pcailliatte/OpenMowerECU/Doc/assets/img/MowerBoard_preview.png

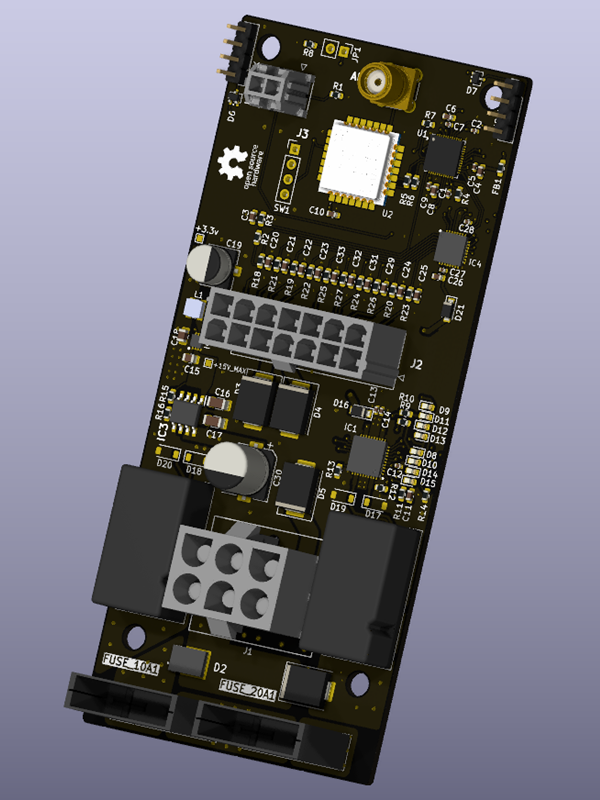
Doc/assets/img/MowerBoard_preview.png
