pcailliatte/OpenMowerECU/Hardware/STAUB_BLIZZARD_107L/MowerBoard.kicad_pcb

## KiCad design Hardware/STAUB_BLIZZARD_107L/MowerBoard.kicad_pcb (2026-08-01)

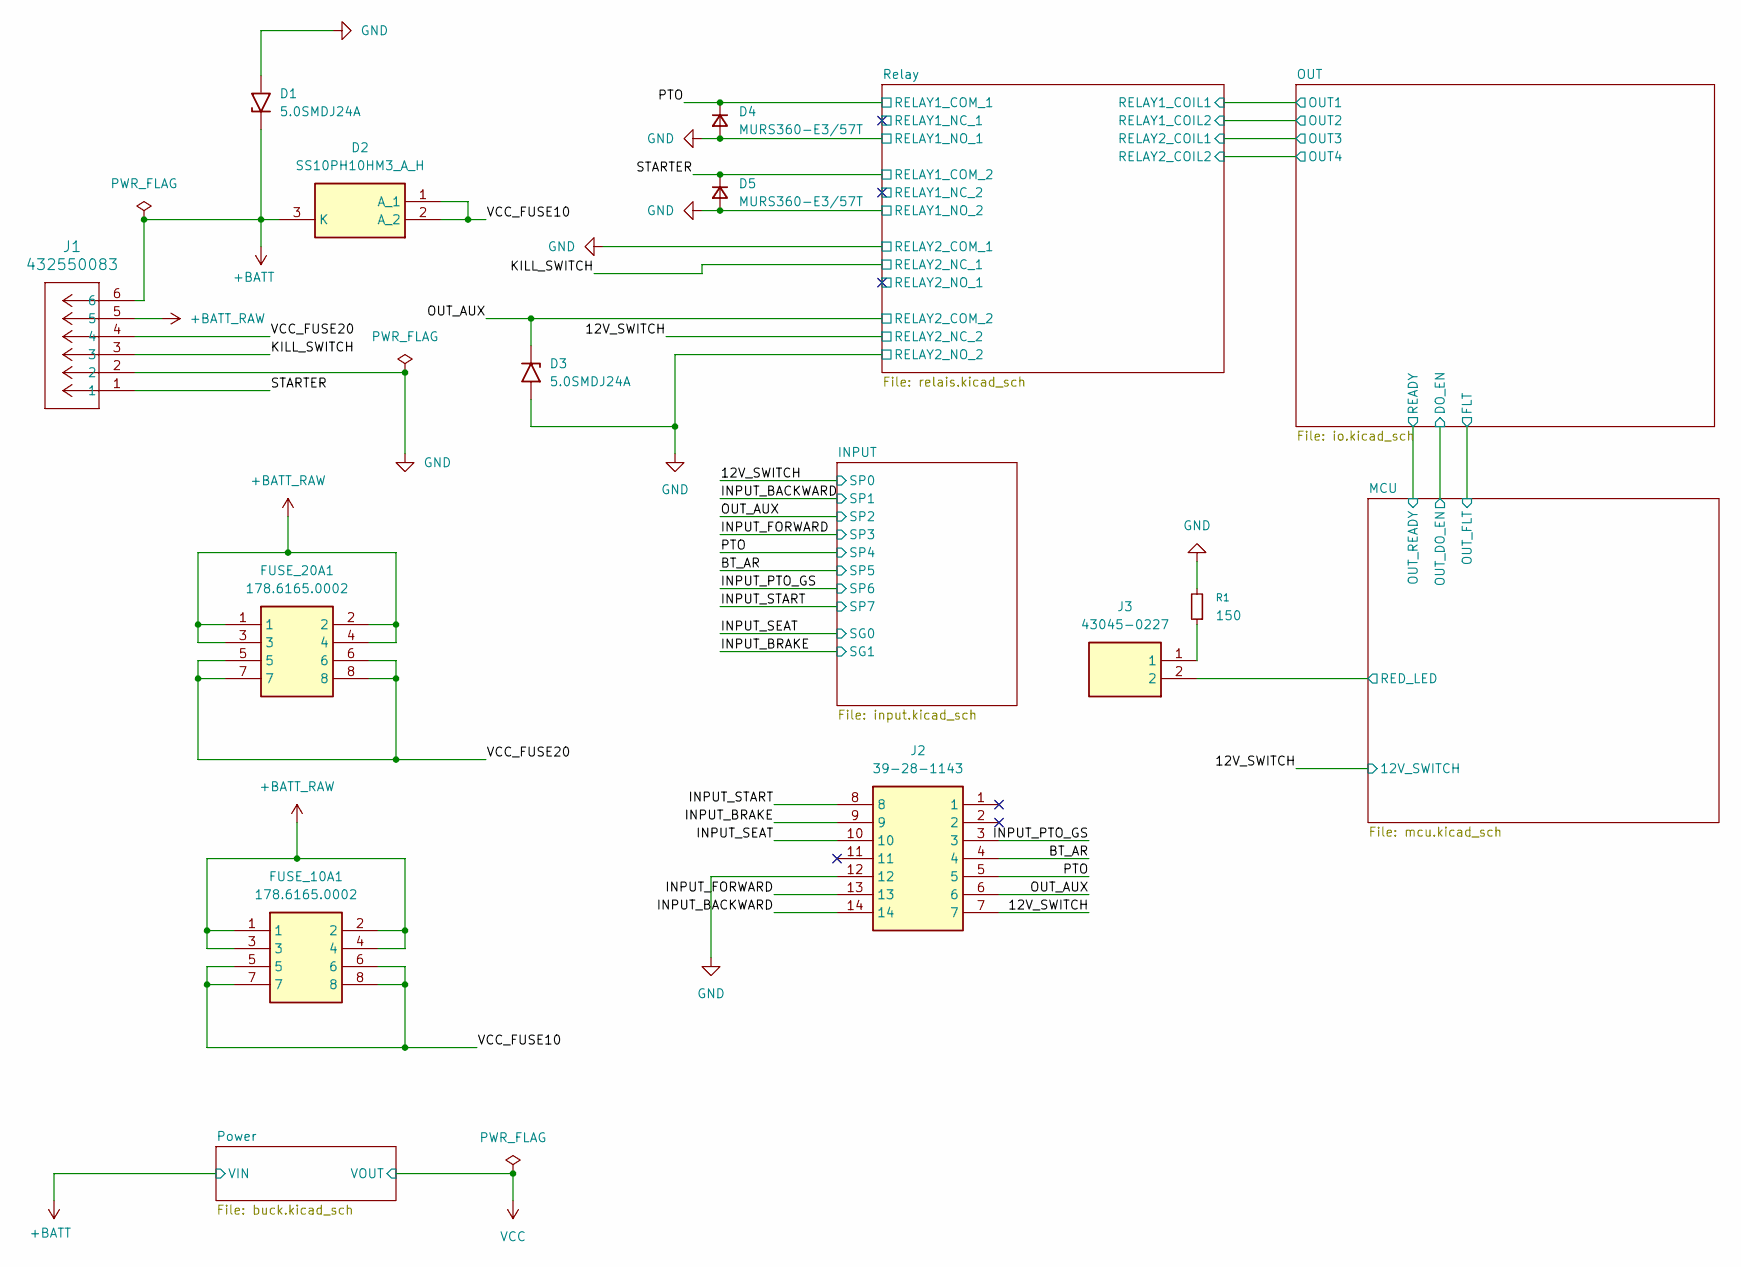
[picture p2: schematic MowerBoard.kicad_sch]

Parts:
D1, D3: 5.0SMDJ24A; D_SMC; Mouser Part Number 576-5.0SMDJ24A
D2: SS10PH10HM3_A_H; V10PN50M387A; Mouser Part Number 78-SS10PH10HM3_A/H
D4, D5: MURS360-E3/57T; D_SMC
FUSE_10A1, FUSE_20A1: 178.6165.0002; 17861650002; Mouser Part Number 576-178.6165.0002
J1: 432550083; CONN_SDA_43255-00xx_06_MOL_NO_MARK
J2: 39-28-1143; Mouser Part Number 538-39-28-1143
J3: 43045-0227; 43045-02YY_272829; Mouser Part Number 538-43045-0227
R1: 150; R_0603_1608Metric

Connections:
+BATT: D1.1 (A1), D2.3 (K), J1.6; also elsewhere on the board
+BATT_RAW: FUSE_10A1.1, FUSE_10A1.2, FUSE_10A1.3, FUSE_10A1.4, FUSE_20A1.1, FUSE_20A1.2, FUSE_20A1.3, FUSE_20A1.4, J1.5
/12V_SWITCH: J2.7; also elsewhere on the board
/BT_AR: J2.4; also elsewhere on the board
/INPUT_BACKWARD: J2.14; also elsewhere on the board
/INPUT_BRAKE: J2.9; also elsewhere on the board
/INPUT_FORWARD: J2.13; also elsewhere on the board
/INPUT_PTO_GS: J2.3; also elsewhere on the board
/INPUT_SEAT: J2.10; also elsewhere on the board
/INPUT_START: J2.8; also elsewhere on the board
/KILL_SWITCH: J1.3; also elsewhere on the board
/MCU/RED_LED: J3.2; also elsewhere on the board
/OUT_AUX: D3.1 (A1), J2.6; also elsewhere on the board
/PTO: D4.1 (K), J2.5; also elsewhere on the board
/STARTER: D5.1 (K), J1.1; also elsewhere on the board
/VCC_FUSE10: D2.1 (A_1), D2.2 (A_2), FUSE_10A1.5, FUSE_10A1.6, FUSE_10A1.7, FUSE_10A1.8
/VCC_FUSE20: FUSE_20A1.5, FUSE_20A1.6, FUSE_20A1.7, FUSE_20A1.8, J1.4
GND: D1.2 (A2), D3.2 (A2), D4.2 (A), D5.2 (A), J1.2, J2.12, R1.2; also elsewhere on the board
unnamed: J3.1, R1.1

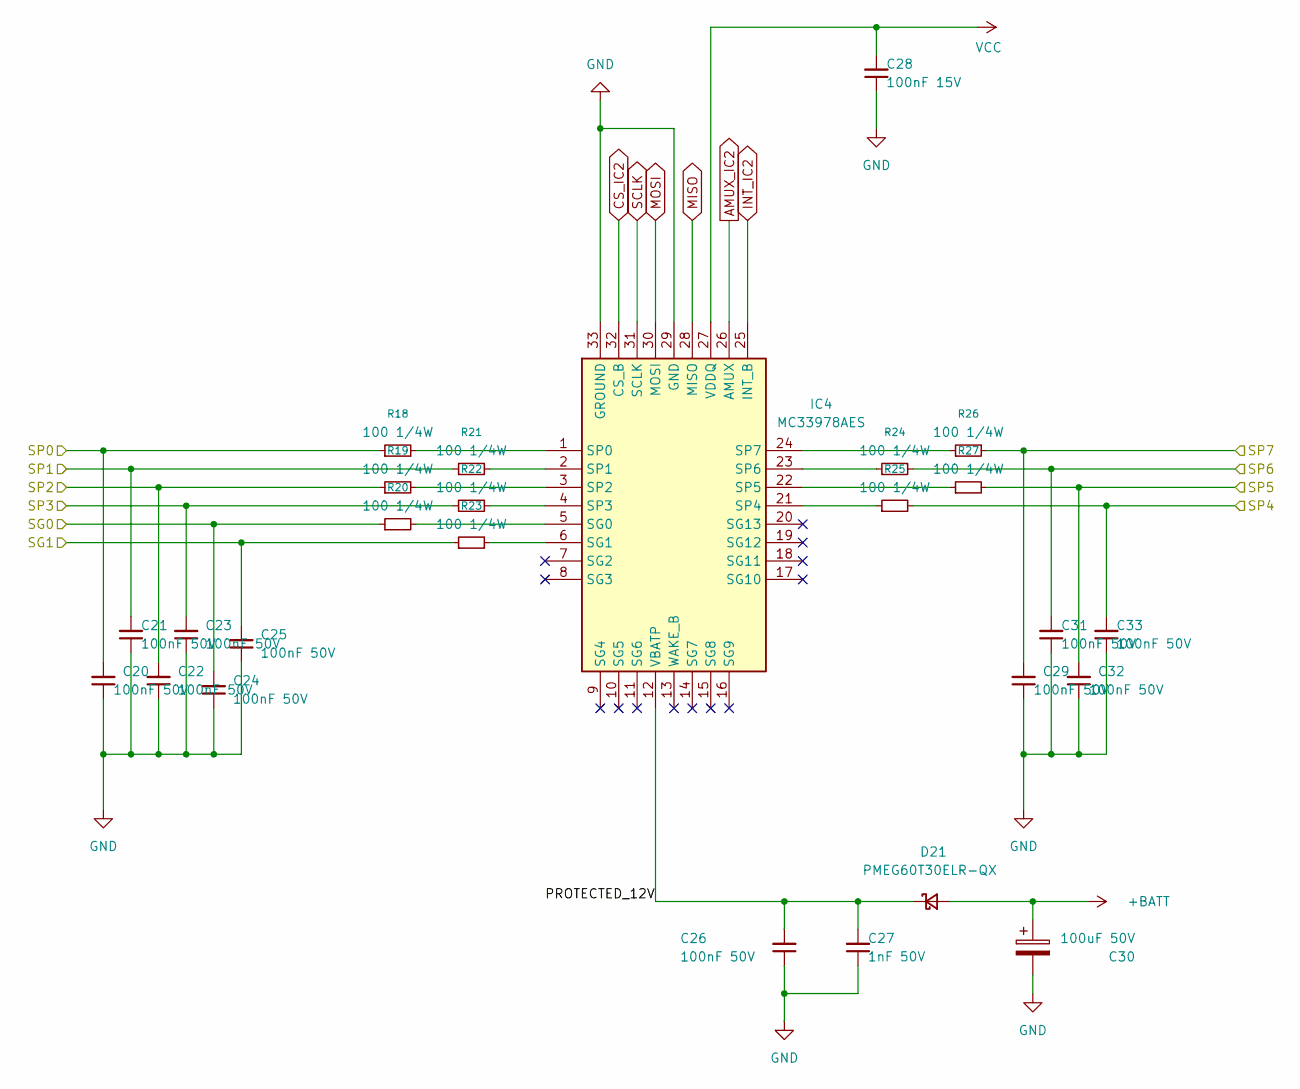
[picture p3: schematic input.kicad_sch]

Parts:
C20, C21, C22, C23, C24, C25, C26, C29, C31, C32, C33: 100nF 50V; C_0603_1608Metric
C27: 1nF 50V; C_0402_1005Metric
C28: 100nF 15V; C_0402_1005Metric
C30: 100uF 50V; CP_Elec_8x10
D21: PMEG60T30ELR-QX; Nexperia_CFP3_SOD-123W
IC4: MC33978AES; QFN50P500X500X90-33N-D_Pasta; Mouser Part Number 841-MC33978AES
R18, R19, R20, R21, R22, R23, R24, R25, R26, R27: 100 1/4W; R_0603_1608Metric

Connections:
+BATT: C30.1, D21.2 (A); also elsewhere on the board
/12V_SWITCH: C20.2, R18.1; also elsewhere on the board
/BT_AR: C32.2, R27.2; also elsewhere on the board
/INPUT/PROTECTED_12V: C26.2, C27.2, D21.1 (K), IC4.12 (VBATP)
/INPUT_BACKWARD: C21.2, R21.1; also elsewhere on the board
/INPUT_BRAKE: C25.2, R23.1; also elsewhere on the board
/INPUT_FORWARD: C23.2, R22.1; also elsewhere on the board
/INPUT_PTO_GS: C31.2, R24.2; also elsewhere on the board
/INPUT_SEAT: C24.2, R20.1; also elsewhere on the board
/INPUT_START: C29.2, R26.2; also elsewhere on the board
/OUT_AUX: C22.2, R19.1; also elsewhere on the board
/PTO: C33.2, R25.2; also elsewhere on the board
AMUX_IC2: IC4.26 (AMUX); also elsewhere on the board
CS_IC2: IC4.32 (CS_B); also elsewhere on the board
GND: C20.1, C21.1, C22.1, C23.1, C24.1, C25.1, C26.1, C27.1, C28.1, C29.1, C30.2, C31.1, C32.1, C33.1, IC4.29 (GND), IC4.33 (GROUND); also elsewhere on the board
INT_IC2: IC4.25 (INT_B); also elsewhere on the board
MISO: IC4.28 (MISO); also elsewhere on the board
MOSI: IC4.30 (MOSI); also elsewhere on the board
unnamed: IC4.5 (SG0), R20.2
unnamed: IC4.6 (SG1), R23.2
unnamed: IC4.1 (SP0), R18.2
unnamed: IC4.2 (SP1), R21.2
unnamed: IC4.3 (SP2), R19.2
unnamed: IC4.4 (SP3), R22.2
unnamed: IC4.21 (SP4), R25.1
unnamed: IC4.22 (SP5), R27.1
unnamed: IC4.23 (SP6), R24.1
unnamed: IC4.24 (SP7), R26.1
SCLK: IC4.31 (SCLK); also elsewhere on the board
VCC: C28.2, IC4.27 (VDDQ); also elsewhere on the board

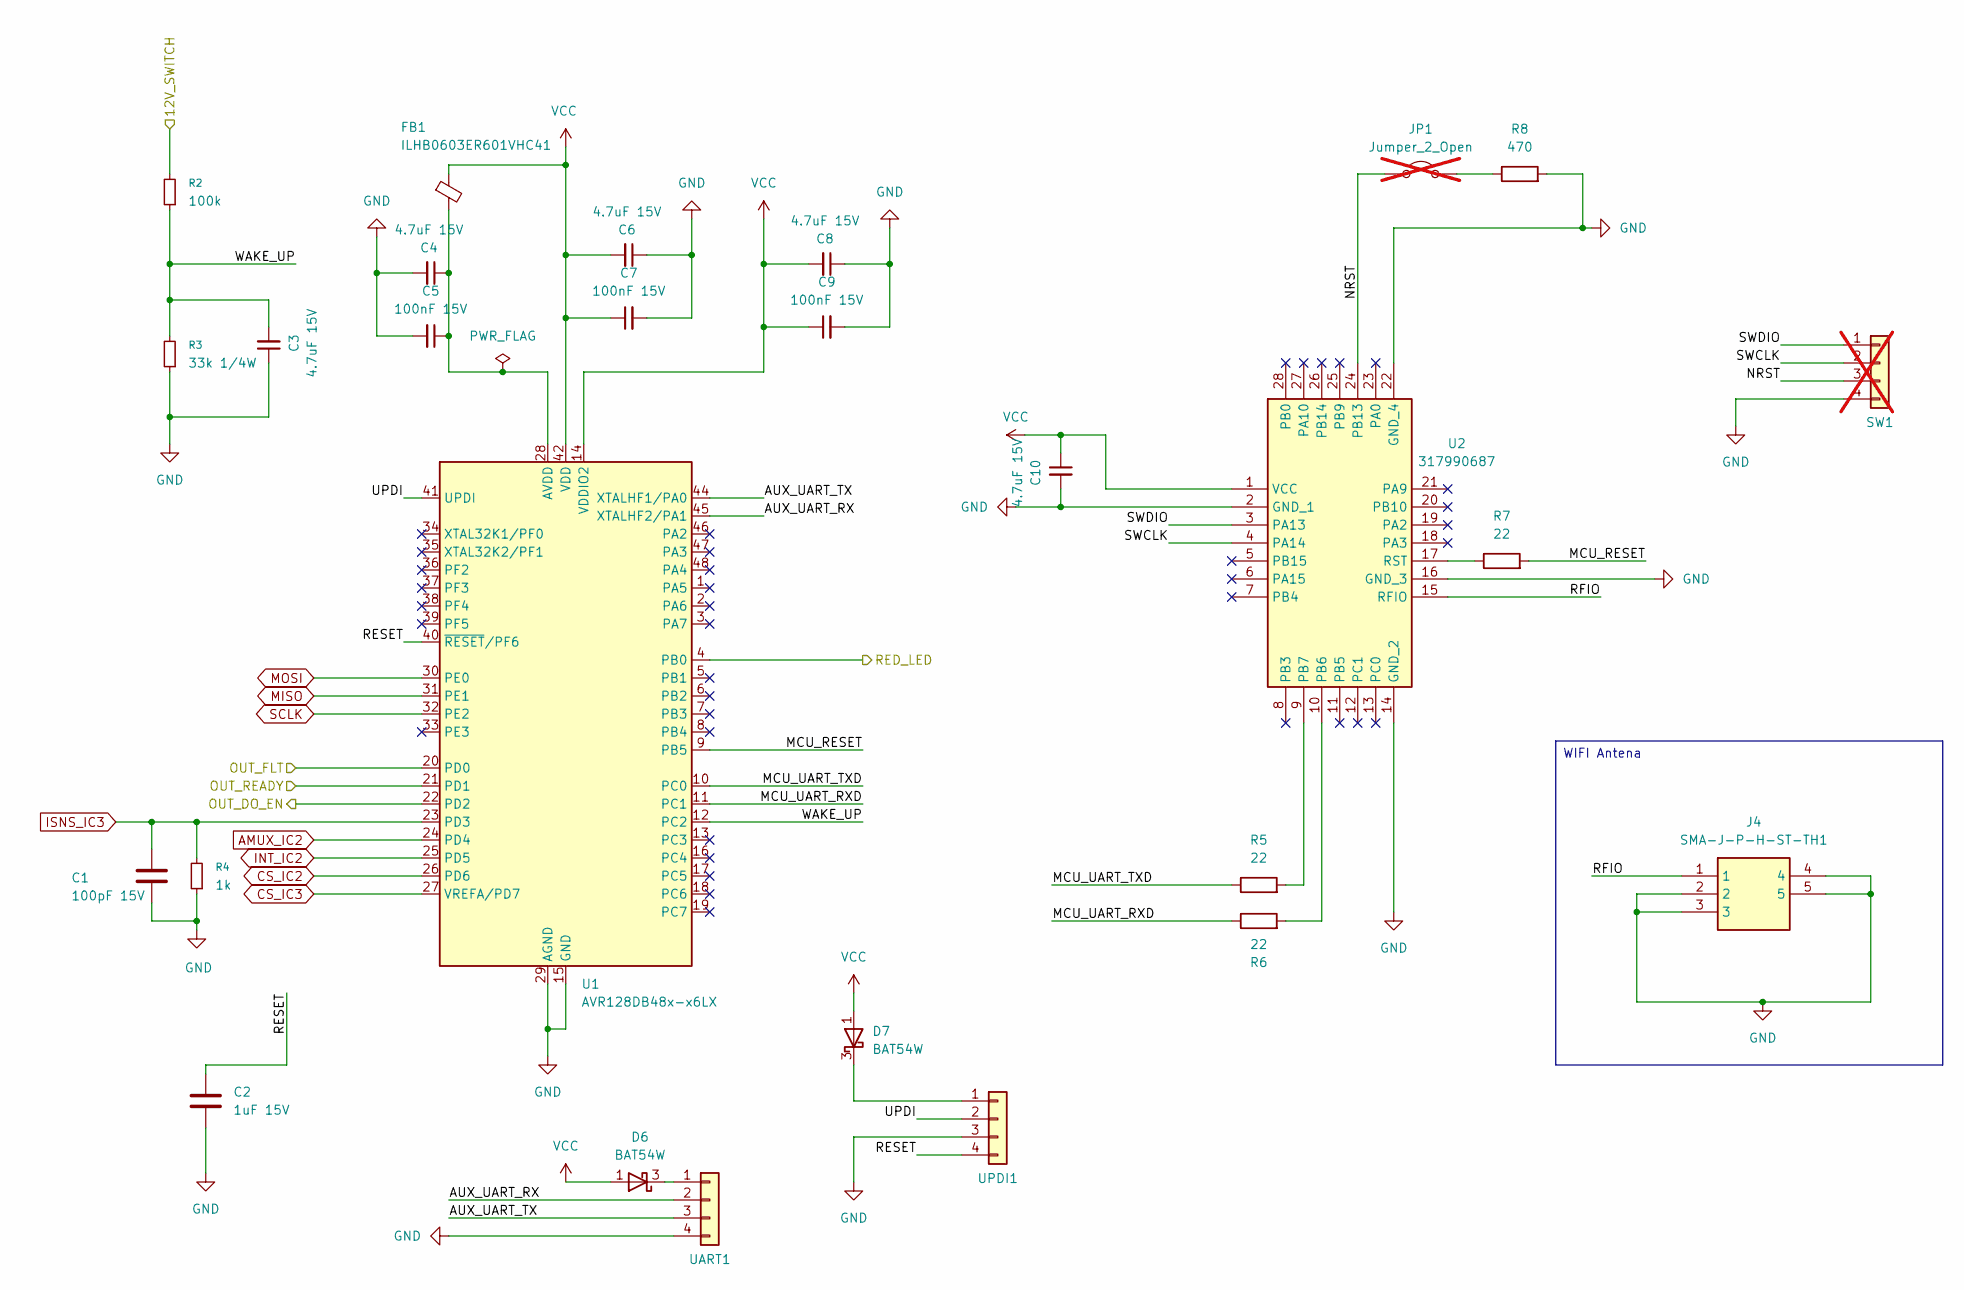
[picture p4: schematic mcu.kicad_sch]

Parts:
C1: 100pF 15V; C_0402_1005Metric
C2: 1uF 15V; C_0402_1005Metric
C3, C4, C6, C8, C10: 4.7uF 15V; C_0603_1608Metric
C5, C7, C9: 100nF 15V; C_0402_1005Metric
D6, D7: BAT54W; SOT-323_SC-70
FB1: ILHB0603ER601VHC41; R_0603_1608Metric_Pad0.98x0.95mm_HandSolder
J4: SMA-J-P-H-ST-TH1; SMAJPHSTTH1; Mouser Part Number 200-SMAJPHSTTH1
JP1: Jumper_2_Open; PinHeader_1x02_P2.54mm_Vertical; not fitted
R2: 100k; R_0603_1608Metric
R3: 33k 1/4W; R_0603_1608Metric
R4: 1k; R_0603_1608Metric
R5, R6, R7: 22; R_0603_1608Metric
R8: 470; R_0603_1608Metric
SW1: PinHeader_1x04_P2.54mm_Vertical; not fitted
U1: AVR128DB48x-x6LX; VQFN-48-1EP_6x6mm_P0.4mm_EP4.1x4.1mm
U2: 317990687; Mouser Part Number 713-317990687
UART1: PinHeader_1x04_P2.54mm_Vertical
UPDI1: PinHeader_1x04_P2.54mm_Vertical

Connections:
/12V_SWITCH: R2.2; also elsewhere on the board
/MCU/AUX_UART_RX: U1.45 (XTALHF2/PA1), UART1.2
/MCU/AUX_UART_TX: U1.44 (XTALHF1/PA0), UART1.3
/MCU/MCU_RESET: R7.2, U1.9 (PB5)
/MCU/MCU_UART_RXD: R6.1, U1.11 (PC1)
/MCU/MCU_UART_TXD: R5.1, U1.10 (PC0)
/MCU/NRST: JP1.1 (A), SW1.3, U2.24 (PB13)
/MCU/OUT_FLT: U1.20 (PD0); also elsewhere on the board
/MCU/OUT_READY: U1.21 (PD1); also elsewhere on the board
/MCU/RED_LED: U1.4 (PB0); also elsewhere on the board
/MCU/RESET: C2.1, U1.40 (~RESET/PF6), UPDI1.4
/MCU/RFIO: J4.1, U2.15 (RFIO)
/MCU/SWCLK: SW1.2, U2.4 (PA14)
/MCU/SWDIO: SW1.1, U2.3 (PA13)
/MCU/UPDI: U1.41 (UPDI), UPDI1.2
/MCU/WAKE_UP: C3.2, R2.1, R3.2, U1.12 (PC2)
/OUT/DO_EN: U1.22 (PD2); also elsewhere on the board
AMUX_IC2: U1.24 (PD4); also elsewhere on the board
CS_IC2: U1.26 (PD6); also elsewhere on the board
CS_IC3: U1.27 (VREFA/PD7); also elsewhere on the board
GND: C1.2, C2.2, C3.1, C4.2, C5.2, C6.1, C7.2, C8.1, C9.2, C10.2, J4.2, J4.3, J4.4, J4.5, R3.1, R4.1, R8.2, SW1.4, U1.15 (GND), U1.29 (AGND), U1.43 (GND), U1.49 (GND), U2.2 (GND_1), U2.14 (GND_2), U2.16 (GND_3), U2.22 (GND_4), UART1.4, UPDI1.3; also elsewhere on the board
INT_IC2: U1.25 (PD5); also elsewhere on the board
ISNS_IC3: C1.1, R4.2, U1.23 (PD3); also elsewhere on the board
MISO: U1.31 (PE1); also elsewhere on the board
MOSI: U1.30 (PE0); also elsewhere on the board
unnamed: D6.3 (K), UART1.1
unnamed: D7.3 (K), UPDI1.1
unnamed: JP1.2 (B), R8.1
unnamed: C4.1, C5.1, FB1.2, U1.28 (AVDD)
unnamed: R6.2, U2.10 (PB6)
unnamed: R5.2, U2.9 (PB7)
unnamed: R7.1, U2.17 (RST)
SCLK: U1.32 (PE2); also elsewhere on the board
VCC: C6.2, C7.1, C8.2, C9.1, C10.1, D6.1 (A), D7.1 (A), FB1.1, U1.14 (VDDIO2), U1.42 (VDD), U2.1 (VCC); also elsewhere on the board

Notes on the sheet:
WIFI Antena

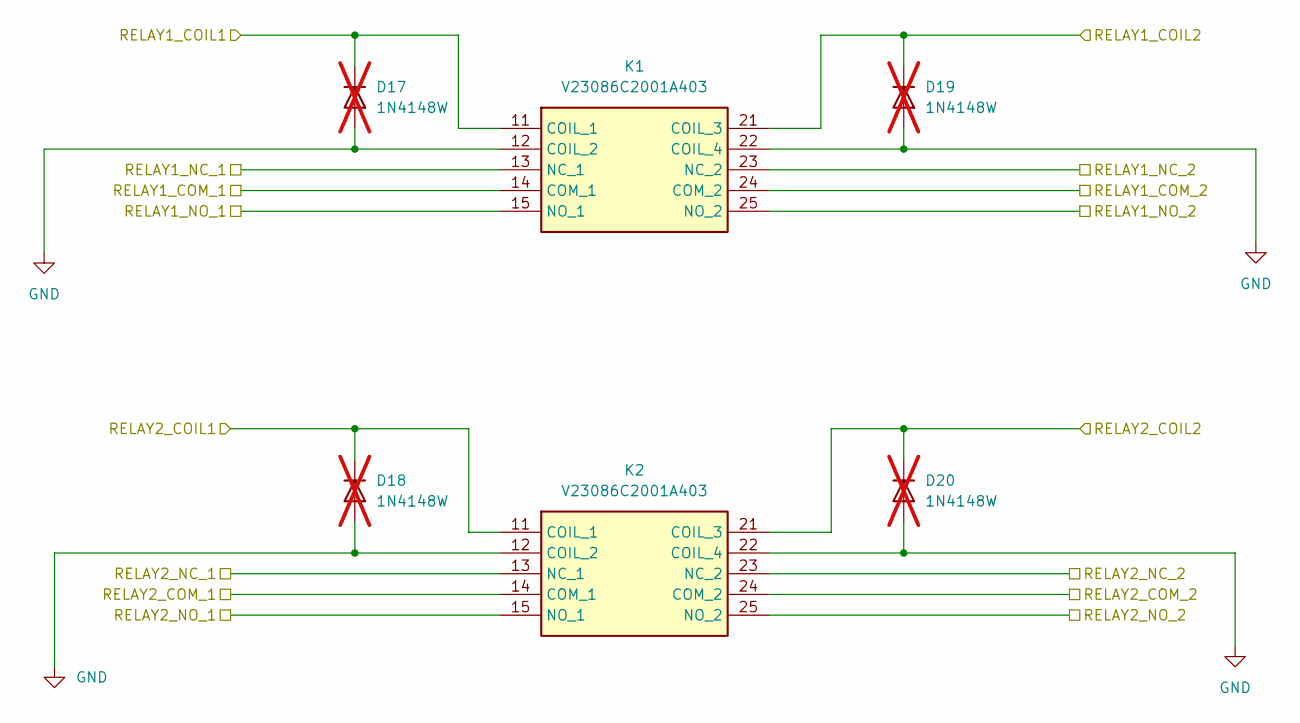
[picture p5: schematic relais.kicad_sch]

Parts:
D17, D18, D19, D20: 1N4148W; D_SOD-123; not fitted
K1, K2: V23086C2001A403; Mouser Part Number 571-1413009-9

Connections:
/12V_SWITCH: K2.23 (NC_2); also elsewhere on the board
/KILL_SWITCH: K2.13 (NC_1); also elsewhere on the board
/OUT/OUT1: D17.1 (K), K1.11 (COIL_1); also elsewhere on the board
/OUT/OUT2: D19.1 (K), K1.21 (COIL_3); also elsewhere on the board
/OUT/OUT3: D18.1 (K), K2.11 (COIL_1); also elsewhere on the board
/OUT/OUT4: D20.1 (K), K2.21 (COIL_3); also elsewhere on the board
/OUT_AUX: K2.24 (COM_2); also elsewhere on the board
/PTO: K1.14 (COM_1); also elsewhere on the board
/Relay/RELAY1_NC_1: K1.13 (NC_1)
/Relay/RELAY1_NC_2: K1.23 (NC_2)
/Relay/RELAY2_NO_1: K2.15 (NO_1)
/STARTER: K1.24 (COM_2); also elsewhere on the board
GND: D17.2 (A), D18.2 (A), D19.2 (A), D20.2 (A), K1.12 (COIL_2), K1.15 (NO_1), K1.22 (COIL_4), K1.25 (NO_2), K2.12 (COIL_2), K2.14 (COM_1), K2.22 (COIL_4), K2.25 (NO_2); also elsewhere on the board

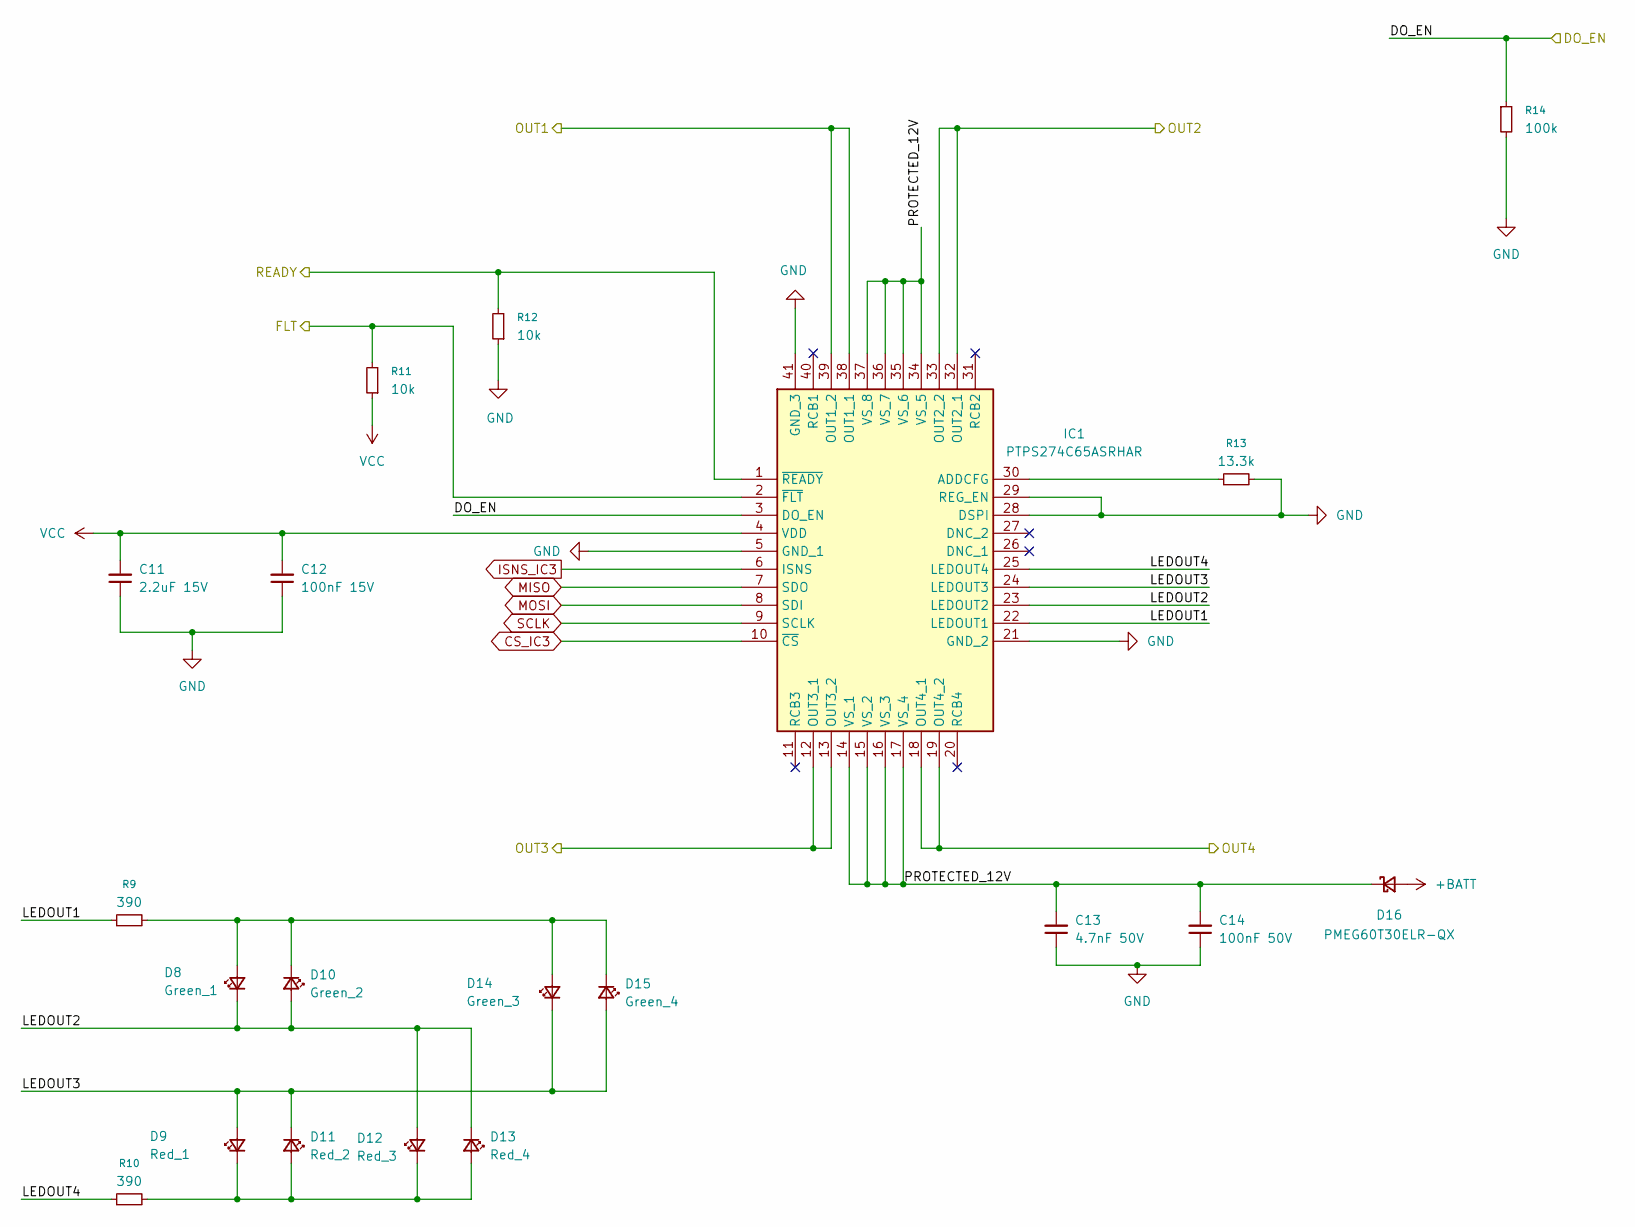
[picture p6: schematic io.kicad_sch]

Parts:
C11: 2.2uF 15V; C_0603_1608Metric
C12: 100nF 15V; C_0402_1005Metric
C13: 4.7nF 50V; C_0402_1005Metric
C14: 100nF 50V; C_0402_1005Metric
D8: Green_1; LED_0603_1608Metric
D9: Red_1; LED_0603_1608Metric
D10: Green_2; LED_0603_1608Metric
D11: Red_2; LED_0603_1608Metric
D12: Red_3; LED_0603_1608Metric
D13: Red_4; LED_0603_1608Metric
D14: Green_3; LED_0603_1608Metric
D15: Green_4; LED_0603_1608Metric
D16: PMEG60T30ELR-QX; Nexperia_CFP3_SOD-123W
IC1: PTPS274C65ASRHAR; QFN50P600X600X100-41N-D_pasta; Manufacturer_Part_Number PTPS274C65ASRHAR
R9, R10: 390; R_0603_1608Metric
R11, R12: 10k; R_0603_1608Metric
R13: 13.3k; R_0603_1608Metric
R14: 100k; R_0603_1608Metric

Connections:
+BATT: D16.2 (A); also elsewhere on the board
/MCU/OUT_FLT: IC1.2 (~FLT), R11.2; also elsewhere on the board
/MCU/OUT_READY: IC1.1 (~READY), R12.2; also elsewhere on the board
/OUT/DO_EN: IC1.3 (DO_EN), R14.1; also elsewhere on the board
/OUT/LEDOUT1: IC1.22 (LEDOUT1), R9.1
/OUT/LEDOUT2: D8.1 (K), D10.2 (A), D12.2 (A), D13.1 (K), IC1.23 (LEDOUT2)
/OUT/LEDOUT3: D9.2 (A), D11.1 (K), D14.1 (K), D15.2 (A), IC1.24 (LEDOUT3)
/OUT/LEDOUT4: IC1.25 (LEDOUT4), R10.1
/OUT/OUT1: IC1.38 (OUT1_1), IC1.39 (OUT1_2); also elsewhere on the board
/OUT/OUT2: IC1.32 (OUT2_1), IC1.33 (OUT2_2); also elsewhere on the board
/OUT/OUT3: IC1.12 (OUT3_1), IC1.13 (OUT3_2); also elsewhere on the board
/OUT/OUT4: IC1.18 (OUT4_1), IC1.19 (OUT4_2); also elsewhere on the board
/OUT/PROTECTED_12V: C13.2, C14.2, D16.1 (K), IC1.14 (VS_1), IC1.15 (VS_2), IC1.16 (VS_3), IC1.17 (VS_4), IC1.34 (VS_5), IC1.35 (VS_6), IC1.36 (VS_7), IC1.37 (VS_8)
CS_IC3: IC1.10 (~CS); also elsewhere on the board
GND: C11.1, C12.1, C13.1, C14.1, IC1.5 (GND_1), IC1.21 (GND_2), IC1.28 (DSPI), IC1.29 (REG_EN), IC1.41 (GND_3), R12.1, R13.2, R14.2; also elsewhere on the board
ISNS_IC3: IC1.6 (ISNS); also elsewhere on the board
MISO: IC1.7 (SDO); also elsewhere on the board
MOSI: IC1.8 (SDI); also elsewhere on the board
unnamed: D8.2 (A), D10.1 (K), D14.2 (A), D15.1 (K), R9.2
unnamed: D9.1 (K), D11.2 (A), D12.1 (K), D13.2 (A), R10.2
unnamed: IC1.30 (ADDCFG), R13.1
SCLK: IC1.9 (SCLK); also elsewhere on the board
VCC: C11.2, C12.2, IC1.4 (VDD), R11.1; also elsewhere on the board

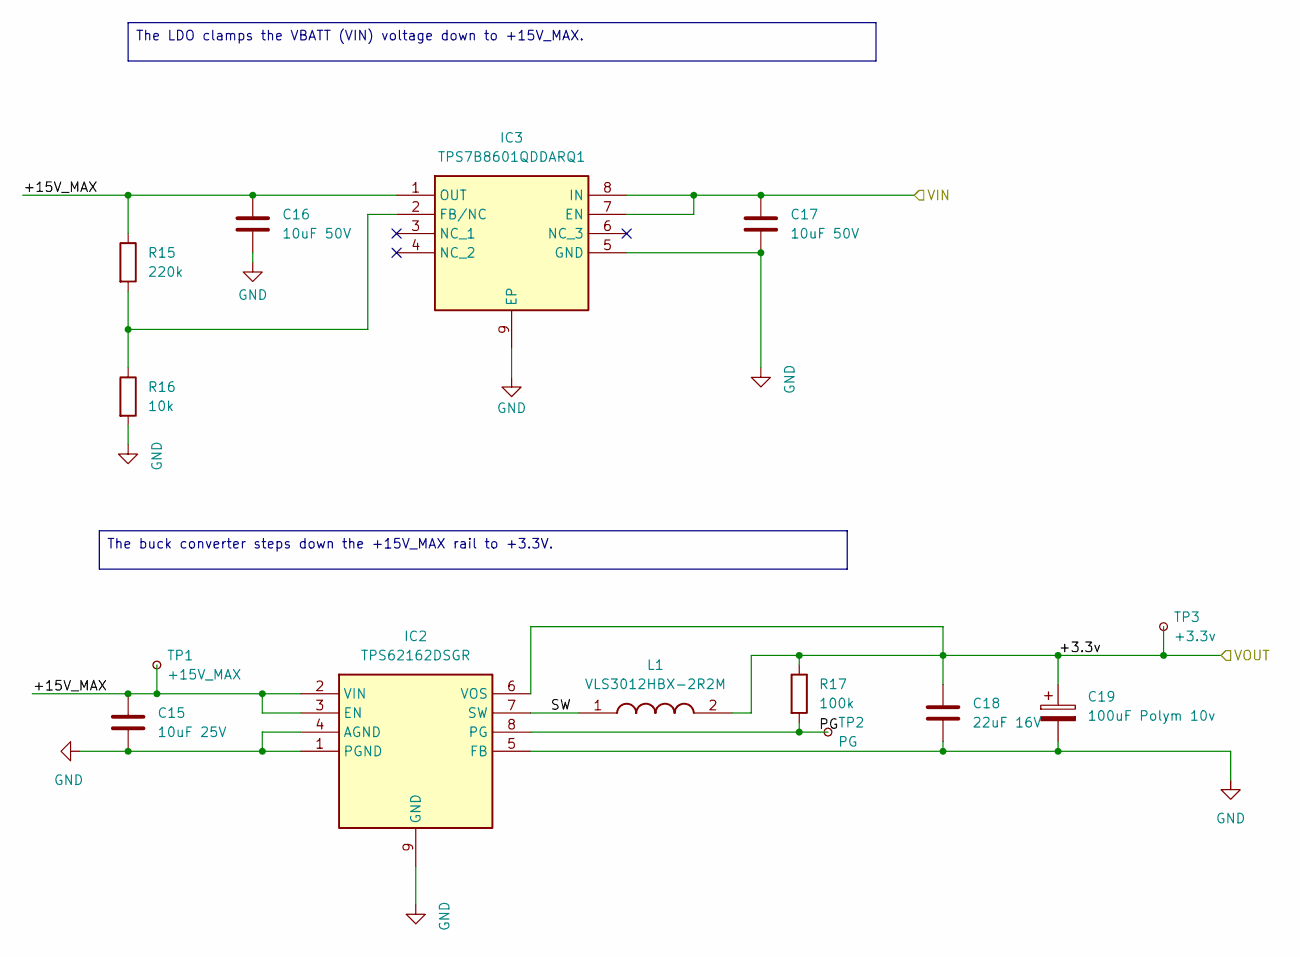
[picture p7: schematic buck.kicad_sch]

Parts:
C15: 10uF 25V; C_0805_2012Metric
C16, C17: 10uF 50V; C_1206_3216Metric
C18: 22uF 16V; C_0805_2012Metric
C19: 100uF Polym 10v; CP_Elec_6.3x5.7
IC2: TPS62162DSGR; SON50P200X200X80-9N; Mouser Part Number 595-TPS62162DSGR
IC3: TPS7B8601QDDARQ1; SOIC127P600X170-9N_pasta; Mouser Part Number 595-TPS7B8601QDDARQ1
L1: VLS3012HBX-2R2M; VLS3012; Mouser Part Number 810-VLS3012HBX-2R2M
R15: 220k; R_0603_1608Metric
R16: 10k; R_0603_1608Metric
R17: 100k; R_0603_1608Metric
TP1: +15V_MAX; TestPoint_Pad_1.0x1.0mm
TP2: PG; TestPoint_Pad_1.0x1.0mm
TP3: +3.3v; TestPoint_Pad_1.0x1.0mm

Connections:
+BATT: C17.1, IC3.7 (EN), IC3.8 (IN); also elsewhere on the board
/Power/+15V_MAX: C15.1, C16.1, IC2.2 (VIN), IC2.3 (EN), IC3.1 (OUT), R15.1, TP1.1 (1_1)
/Power/PG: IC2.8 (PG), R17.2, TP2.1 (1_1)
/Power/SW: IC2.7 (SW), L1.1
GND: C15.2, C16.2, C17.2, C18.2, C19.2, IC2.1 (PGND), IC2.4 (AGND), IC2.5 (FB), IC2.9 (GND), IC3.5 (GND), IC3.9 (EP), R16.2; also elsewhere on the board
unnamed: IC3.2 (FB/NC), R15.2, R16.1
VCC: C18.1, C19.1, IC2.6 (VOS), L1.2, R17.1, TP3.1 (1_1); also elsewhere on the board

Notes on the sheet:
The buck converter steps down the +15V_MAX rail to +3.3V.
The LDO clamps the VBATT (VIN) voltage down to +15V_MAX.

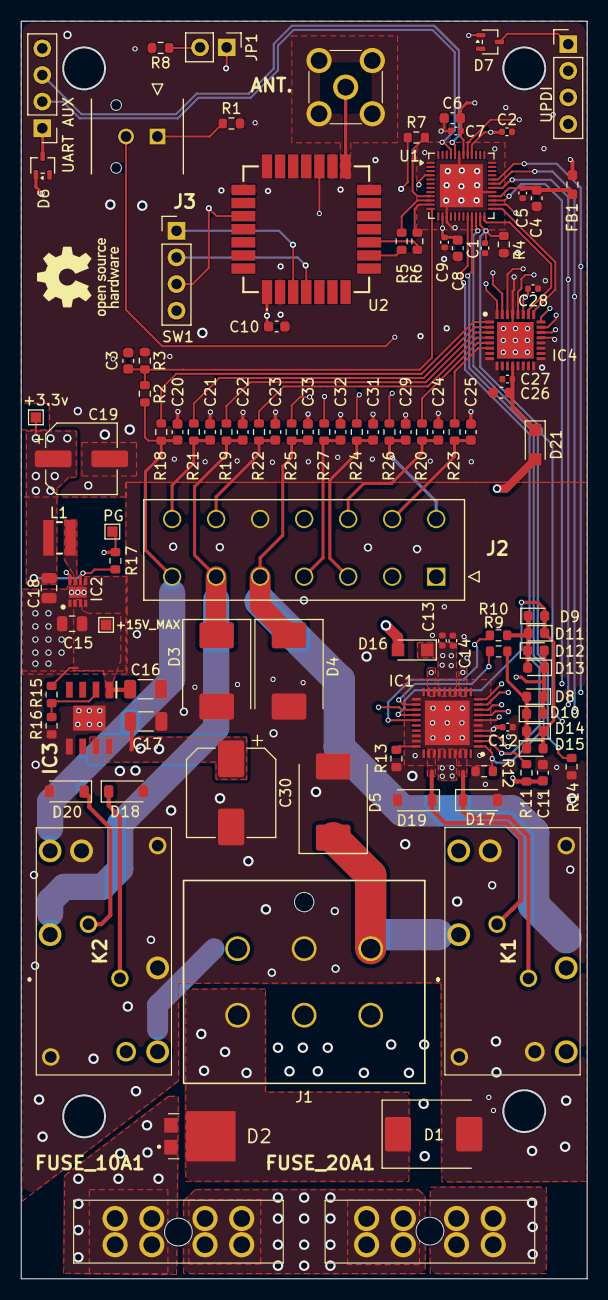
[picture p8: board MowerBoard.kicad_pcb from above]

Board: 4 copper layers, 54.0 x 120.0 mm, 104 parts (0 on the bottom side), 77 nets.
