pcailliatte/OpenMowerECU/(commit log)

2026-07-26 RC2 du PCB, corrigé taille des vias et isolation. Ajout via GND. Reprise des leds de status
    [MowerBoard.kicad_pcb, buck.kicad_sch]
2026-07-26 Ajout des datasheet, correction des metadata et typo de certain composants.
    [MowerBoard.kicad_sch, mcu.kicad_sch]
2026-07-28 Travail sur le BOM, changement de quelques empreintes pour aligner sur les disponibilités
    [MowerBoard.kicad_pcb, MowerBoard.kicad_sch, buck.kicad_sch, input.kicad_sch, io.kicad_sch, mcu.kicad_sch]
2026-07-28 Ajout du BOM.md
2026-07-28 Add bom.csv from BOM.md with semicolon separator
    [bom.csv]
2026-07-28 Add Qty to Order column with +30% for C/R 0402/0603/0805 and LEDs
    [bom.csv]
2026-08-01 Ajout du connecteur de programmation du module Lora
    [MowerBoard.kicad_pcb, MowerBoard.kicad_sch, buck.kicad_sch, input.kicad_sch, io.kicad_sch, mcu.kicad_sch, relais.kicad_sch]
2026-08-02 Mise à jour de l'image du projet
